CamiloParraS/Proyecto-Arduino-1er-Semestre/Video, Imagenes - Funcionamiento/Imagenes/20241130_105605.jpg

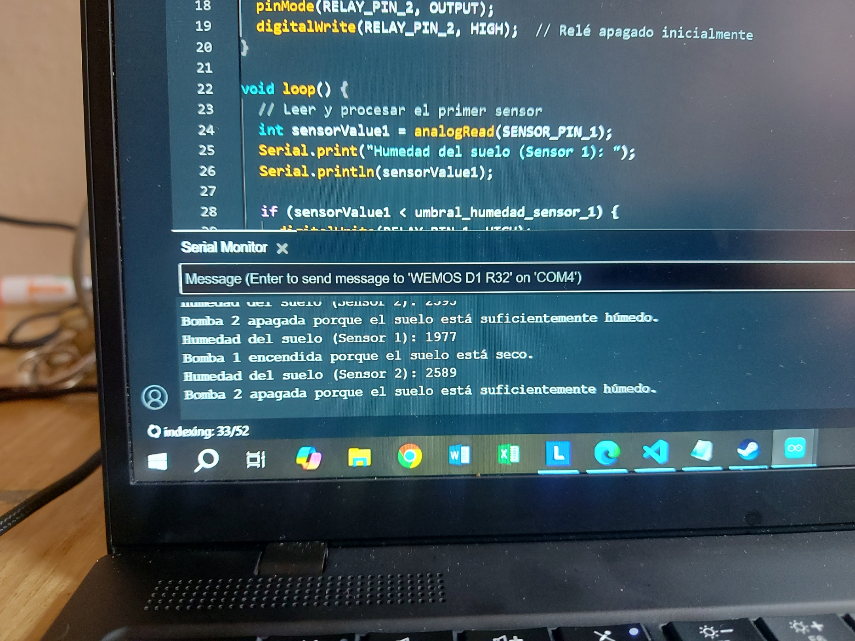
Video, Imagenes - Funcionamiento/Imagenes/20241130_105605.jpg
