CamiloParraS/Proyecto-Arduino-1er-Semestre/README.md

En este proyecto se desarrolló un sistema de riego automatizado para plantas utilizando un microcontrolador ESP32. El objetivo principal es monitorear los niveles de humedad del suelo y controlarlos de manera. Esto se logra integrando sensores de humedad, módulos de relé y conectividad Wi-Fi para proporcionar una solución autónoma y accesible desde cualquier dispositivo conectado a la misma red. 

El sistema se compone de dos sensores de humedad, los cuales miden el nivel de humedad en dos plantas de manera independiente. A partir de estos datos, el ESP32 decide si activar o desactivar las bombas de riego, garantizando así que las plantas se mantengan dentro de un rango óptimo de humedad. Este control automático asegura un riego eficiente, reduce el desperdicio de agua y evita el exceso de riego que podría dañar las plantas. 

Una característica clave de este sistema es la implementación de un servidor web en el ESP32, accesible desde cualquier navegador. Esta interfaz web permite al usuario visualizar en tiempo real los niveles de humedad, el porcentaje relativo de humedad del suelo y el estado de las bombas de agua (encendidas o apagadas). Además, la página web se actualiza dinámicamente mediante solicitudes asíncronas, lo que brinda al usuario una experiencia interactiva y fluida. 

El diseño del sistema es altamente escalable y puede adaptarse para gestionar múltiples plantas o incluir funcionalidades adicionales, como el control remoto desde una aplicación móvil. Este proyecto no solo facilita el cuidado de las plantas, sino que también representa una solución tecnológica para la agricultura urbana y doméstica, promoviendo la eficiencia en el uso de recursos y el acceso a tecnologías modernas en el hogar.
