CamiloParraS/Proyecto-Arduino-1er-Semestre/Impresiones - Maquinas virtuales/Impresiones 3D.pdf

Camilo Parra 1

Juan Camilo Parra Sanchez - 917079

Contexto de la ingenieria de software

Impresiones Finales 3D

Diseño propio

Impresión llavero con nombre y apellido propio con iniciales universidad cooperativa de

Colombia

Enlace TinkerCad: https://www.tinkercad.com/things/jM9nPLklUSw-

llaverocamiloparra?sharecode=Sq1zZamawX8C2Zq_kR-aMNQ_KgQ4RsizLtIJGYdPl1Y (https://www.tinkercad.com/things/jM9nPLklUSw-llaverocamiloparra)

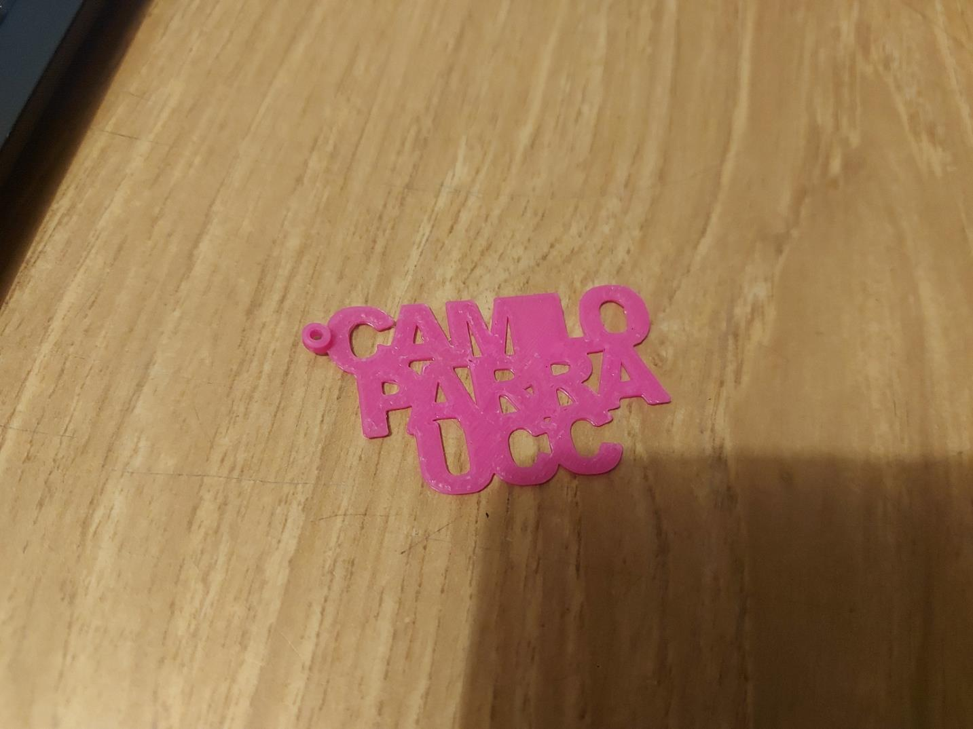
[picture p13: figure]

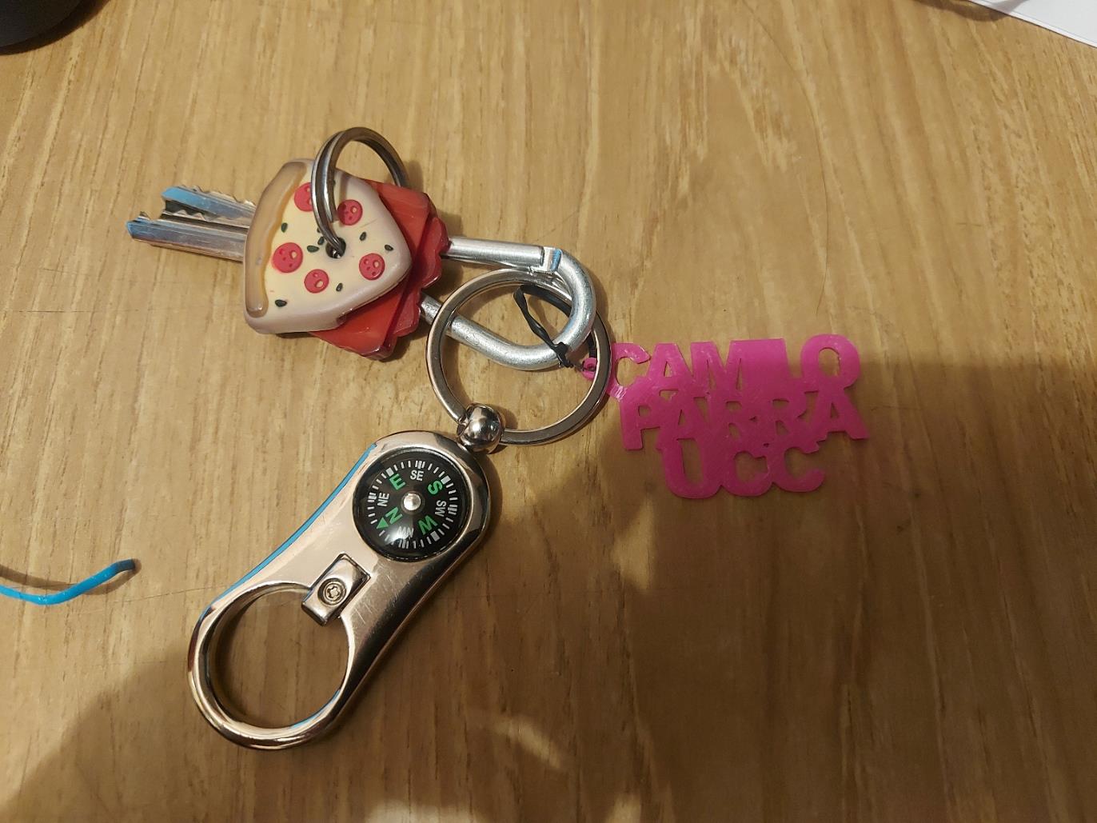
[picture p14: figure]

Diseño Externo

https://www.tinkercad.com/things/jM9nPLklUSw-

llaverocamiloparra?sharecode=Sq1zZamawX8C2Zq_kR-aMNQ_KgQ4RsizLtIJGYdPl1Y (https://www.tinkercad.com/things/jM9nPLklUSw-llaverocamiloparra)

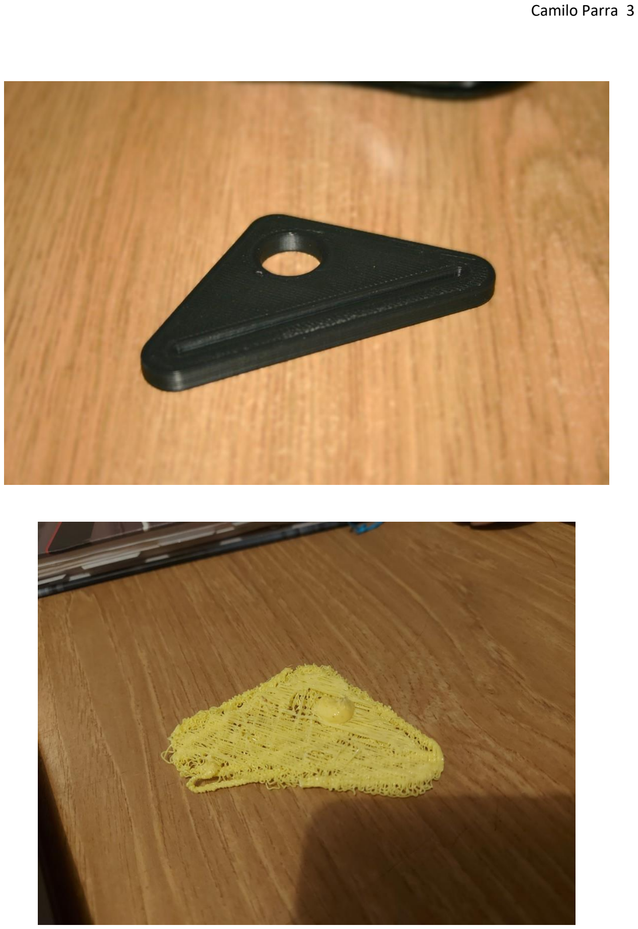
[picture p15: page 3]

Diseño externo

PLANT KEEPER – Automated Plant Watering System by Emilostuff - Thingiverse (https://www.thingiverse.com/thing:4681068)

Nota: El diseño fue hecho en un lugar externo a la universidad debido a problemas

de disponibilidad de esta y también por problemas en la duración del mantenimiento de

esta

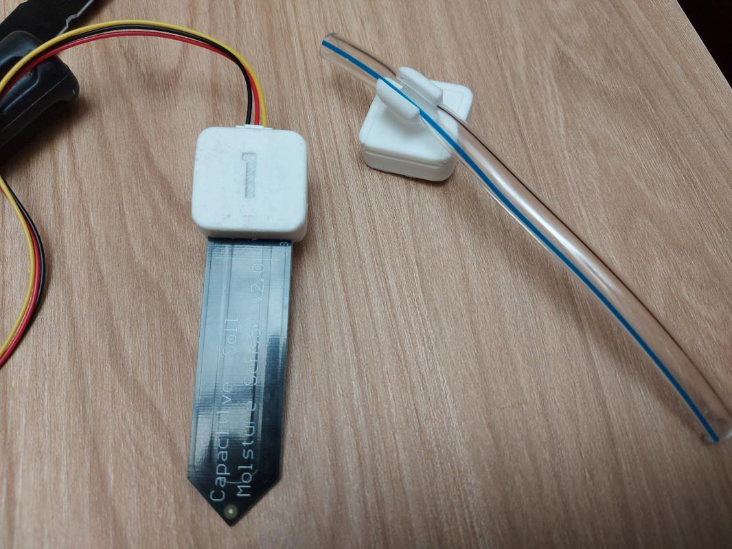
[picture p16: figure]

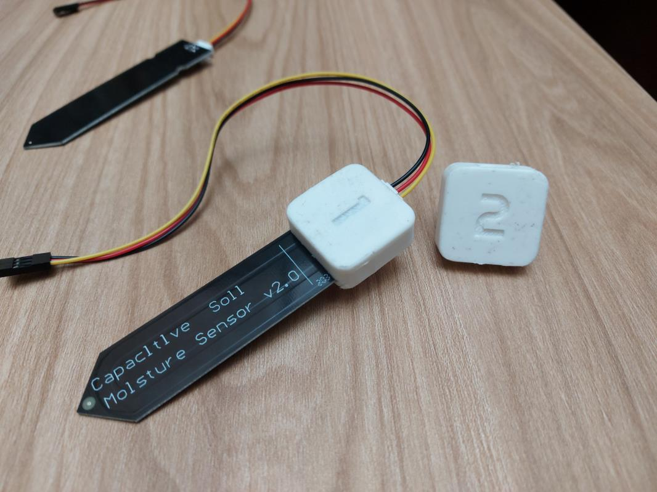
[picture p17: figure]
