CamiloParraS/Proyecto-Arduino-1er-Semestre/Video, Imagenes - Funcionamiento/Imagenes/20241129_183134.jpg

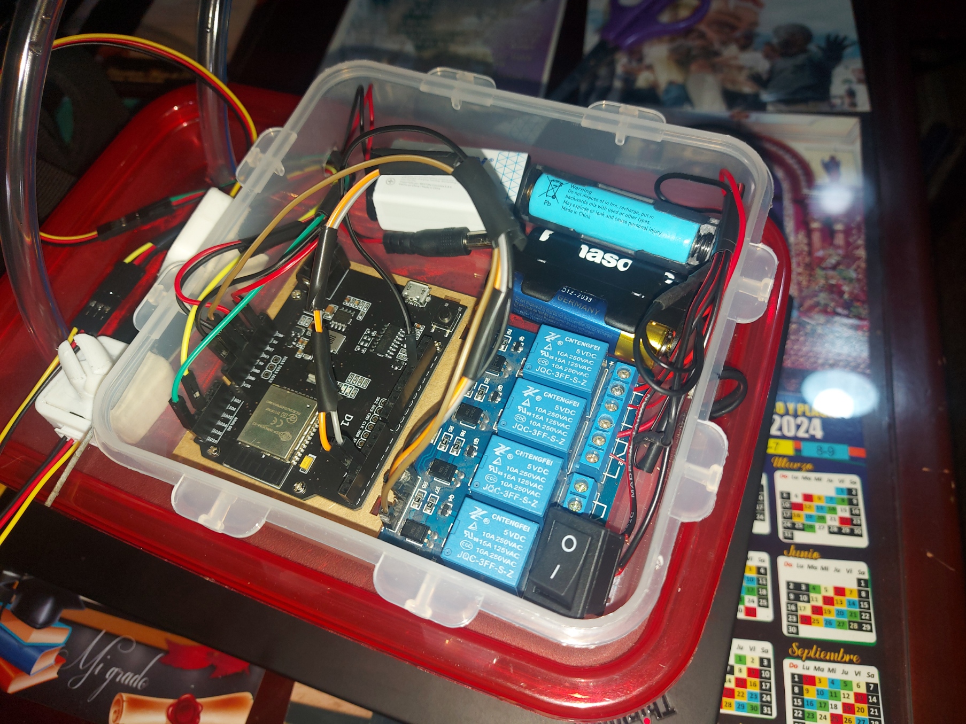
Video, Imagenes - Funcionamiento/Imagenes/20241129_183134.jpg
