CamiloParraS/Proyecto-Arduino-1er-Semestre/Video, Imagenes - Funcionamiento/Imagenes/20241130_110002.jpg

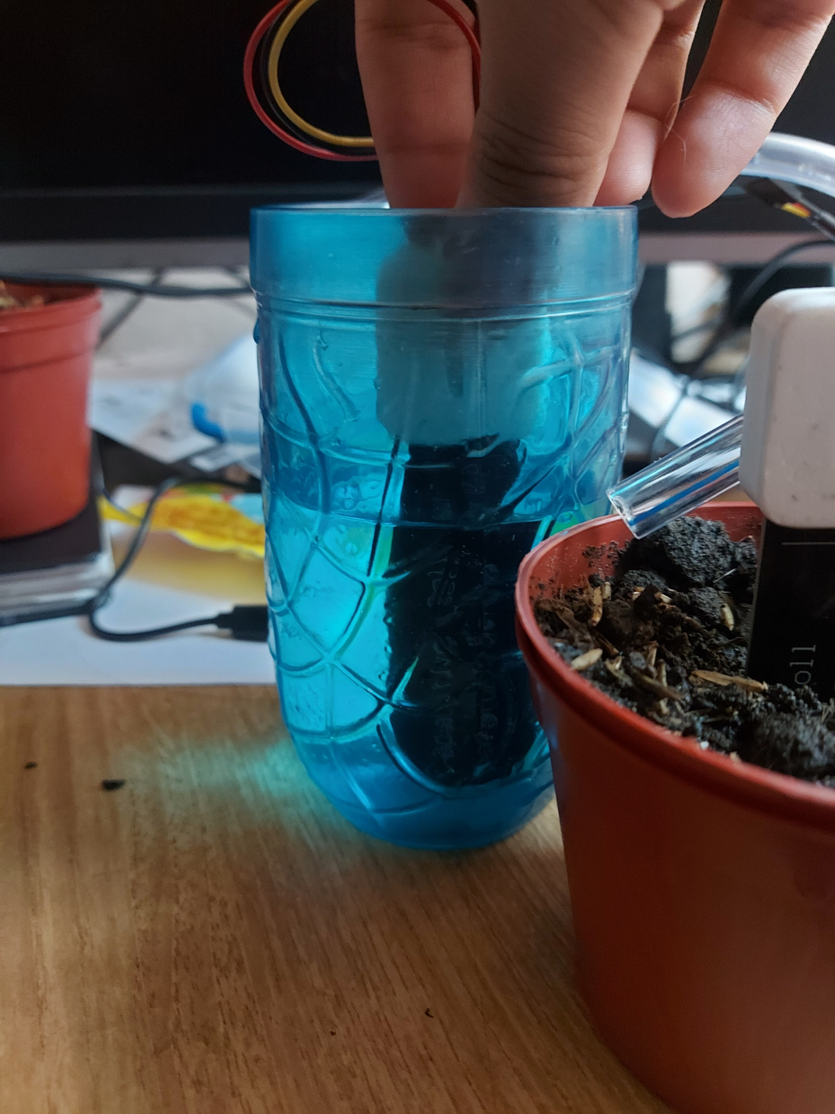
Video, Imagenes - Funcionamiento/Imagenes/20241130_110002.jpg
