CamiloParraS/Proyecto-Arduino-1er-Semestre/Video, Imagenes - Funcionamiento/Imagenes/20241201_130102.jpg

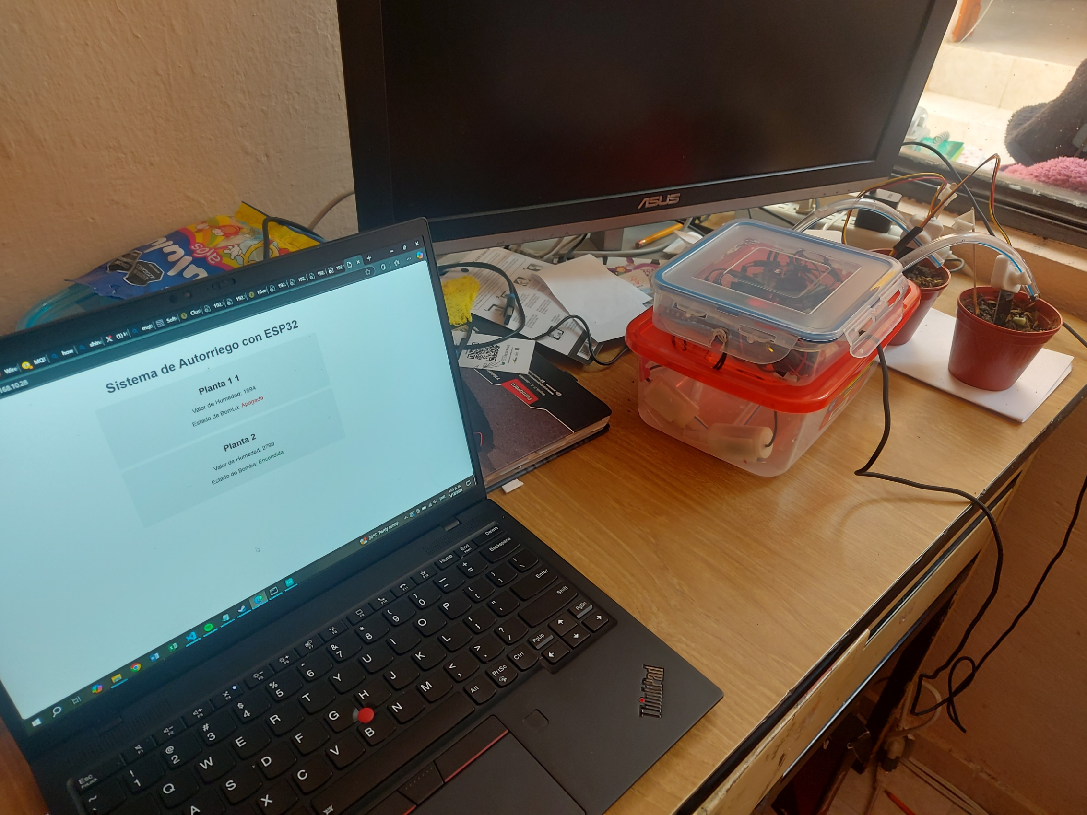
Video, Imagenes - Funcionamiento/Imagenes/20241201_130102.jpg
