CamiloParraS/Proyecto-Arduino-1er-Semestre/Documento guia/Esquema riego ESP32.pdf

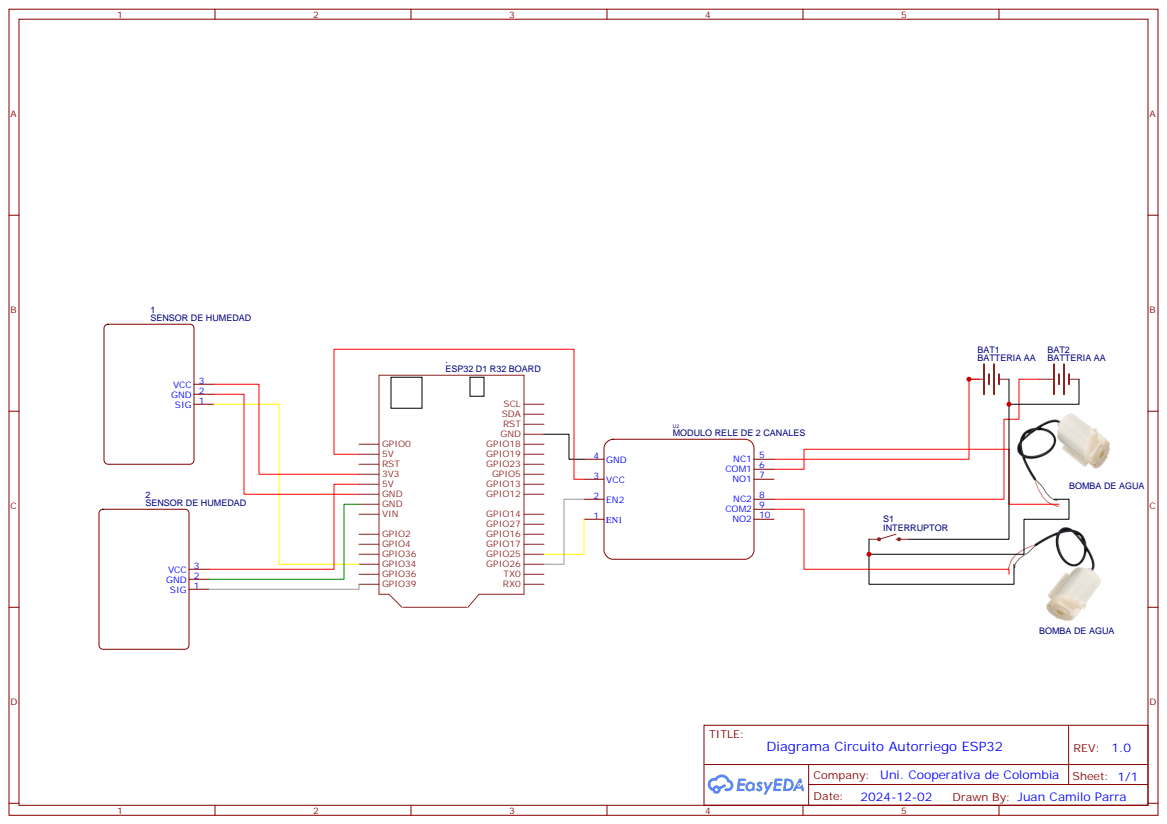
[picture p23: page 1]

MODULO RELE DE 2 CANALES

Company: Uni. Cooperativa de Colombia

Drawn By: Juan Camilo Parra
