CamiloParraS/Proyecto-Arduino-1er-Semestre/(commit log)

2024-12-01 "Deleted file Autorriego esp32.ino"
2024-12-01 "Added WiFi and MQTT connectivity to autorriego_esp32.ino, including WiFi credentials, MQTT server and client configuration, and publishing sensor data to MQTT topics."
2024-12-01 "Replaced MQTT client with WebServer, added WiFi credentials, and modified sensor handling and relay control logic."
    [autorriego_esp32.ino]
2024-12-01 "Updated WiFi credentials, variable names, and comments to Spanish. Changed pin definitions and relay initial states."
2024-12-01 "Renamed CSS class 'sensor-data' to 'datosSensor' in HTML code."
2024-12-02 Esquema de conexiones
