CamiloParraS/Proyecto-Arduino-1er-Semestre/Video, Imagenes - Funcionamiento/Videos/20241201_134533.jpg

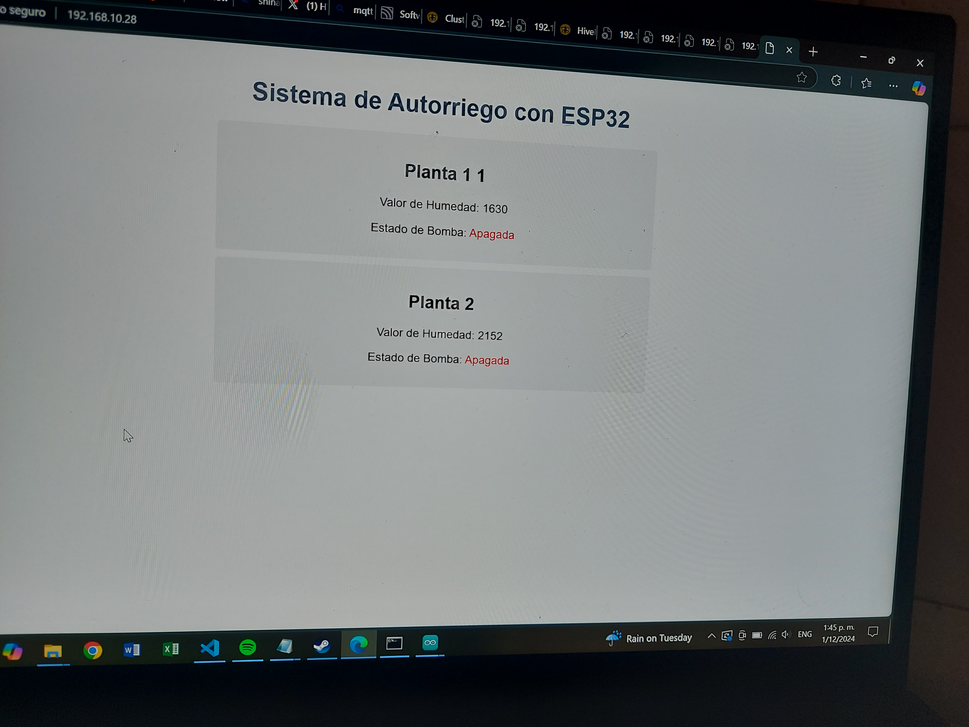
Video, Imagenes - Funcionamiento/Videos/20241201_134533.jpg
